sellensr/Vent/Vent_5/sensorPQ.ino

/**************************************************************************/
/*!
  @file sensorPQ.ino

  @section intro Introduction

  An Arduino sketch for running tests on an HMRC DIY ventilator. sensorPQ tab.
  Provides functions to measure patient pressure and flow rate.

  @section author Author

  Written by

  @section license License

  CCBY license

  Code provided only for example purposes. Must not be used for any purpose 
  critical to life or health, or protection of property.
*/
/**************************************************************************/
#ifdef P_BME280
#include <Adafruit_Sensor.h>
#include <Adafruit_BME280.h>
Adafruit_BME280 bmeA, bmeV; // I2C

/**************************************************************************/
/*!
    @brief Do any setup required for patient pressure measurement
    @param none
    @return none
*/
/**************************************************************************/
void setupP(){  // do any setup required for pressure measurement
  unsigned status = bmeA.begin(0x77);  
  PR("bmeA started\n");
  if (!status) {
      Serial.println("Could not find a valid BME280 sensor, check wiring, address, sensor ID!");
      Serial.print("SensorID was: 0x"); Serial.println(bmeA.sensorID(),16);
      Serial.print("        ID of 0xFF probably means a bad address, a BMP 180 or BMP 085\n");
      Serial.print("   ID of 0x56-0x58 represents a BMP 280,\n");
      Serial.print("        ID of 0x60 represents a BME 280.\n");
      Serial.print("        ID of 0x61 represents a BME 680.\n");
  }
  status = bmeV.begin(0x76);  
  if (!status) {
      Serial.println("Could not find a valid BME280 sensor, check wiring, address, sensor ID!");
      Serial.print("SensorID was: 0x"); Serial.println(bmeV.sensorID(),16);
      Serial.print("        ID of 0xFF probably means a bad address, a BMP 180 or BMP 085\n");
      Serial.print("   ID of 0x56-0x58 represents a BMP 280,\n");
      Serial.print("        ID of 0x60 represents a BME 280.\n");
      Serial.print("        ID of 0x61 represents a BME 680.\n");
  }
}
 
/**************************************************************************/
/*!
    @brief Get a new value for patient pressure. Be sure to use pull up
    resistors of about 10K on both SDA and SCL, especially if lines get
    longer or stray close to things like servo motors!
    @param none
    @return the current value for patient pressure in cm H20
*/
/**************************************************************************/
double getP(){  // return the current value for patient pressure in cm H20
  static double dP = 0.0;
  double TA = 0, PA = 0, TV = 0, PV = 0;
  // Measure current state
  TA = bmeA.readTemperature();
  PA = bmeA.readPressure(); // Pa
  TV = bmeV.readTemperature();
  PV = bmeV.readPressure(); // Pa
  //P(PA);PCSL(PV);
  dP = dP * 0.9 + (PV - PA - 0.0) * 0.1; 
  return dP * 100 / 998 / 9.81;    // cm H2O   
}
#endif

#ifdef P_PX137
void setupP(){  // do any setup required for pressure measurement
  
}
 
double getP(){  // return the current value for patient pressure in cm H20
  double v = uno.getV(A_PX137); // instantaneous voltage
  double w = v_tauW; // weighting factor for exponential smoothing
  v_px137v = v_px137v * (1-w) + v * w; // smoothed voltage
  double p = (v_px137v - p_pOffset) * p_pScale;
  return p;   
}
#endif

#ifdef P_NONE
void setupP(){  // do any setup required for pressure measurement
  
}
 
double getP(){  // return the current value for patient pressure in cm H20
  return 0.42;   
}
#endif

#ifdef Q_NONE
/**************************************************************************/
/*!
    @brief Do any setup required for patient flow measurement
    @param none
    @return none
*/
/**************************************************************************/
void setupQ(){  // do any setup required for flow measurement
  
}

/**************************************************************************/
/*!
    @brief Get a new value for patient flow
    @param none
    @return the current value for patient flow in litres / minute
*/
/**************************************************************************/
double getQ(){  // return the current value for patient flow in litres / minute
  return 0.42;
}
#endif

#ifdef Q_PX137
void setupQ(){  // do any setup required for flow measurement
  
}

double getQ(){  // return the current value for patient flow in litres / minute
  double v = uno.getV(A_VENTURI); // instantaneous voltage
  double w = v_tauW; // weighting factor for exponential smoothing
  v_venturiv = v_venturiv * (1-w) + v * w; // smoothed voltage
  double p = (v_venturiv - OFFSET_VENTURI) * PSCALE_VENTURI;
  double q = pow(abs(p),0.5) * QSCALE_VENTURI; 
  // do this supression somewhere else like at the display
  // if(q < MINQ_VENTURI) q = 0; // supress small noisy values for optics!
  return q;
}
#endif

#ifdef Q_CAP2
void setupQ(){  // do any setup required for flow measurement
  for(int i = 0; i < 100; i++){
    v_CPAPv = uno.getV(A_CAP_CPAP);  
    v_PEEPv = uno.getV(A_CAP_PEEP);  
  }
}

double getQ(){  // return the current value for patient flow in litres / minute
  double w = v_tauW; // weighting factor for exponential smoothing
  double v = uno.getV(A_CAP_CPAP); // instantaneous voltage
  v_CPAPv = v_CPAPv * (1-w) + v * w; // smoothed voltage
  v = uno.getV(A_CAP_PEEP); // instantaneous voltage
  v_PEEPv = v_PEEPv * (1-w) + v * w; // smoothed voltage
  v_qCPAP = (v_CPAPv - p_qOffsetCPAP) * p_qScaleCPAP;  // flow on the CPAP side
  v_qPEEP = (v_PEEPv - p_qOffsetPEEP) * p_qScalePEEP;  // minus return flow on the PEEP side
  return v_qCPAP - v_qPEEP;
}
double getQCPAP(){  // return the instantaneous value for CPAP side flow in litres / minute
  return (uno.getV(A_CAP_CPAP) - p_qOffsetCPAP) * p_qScaleCPAP;  // flow on the CPAP side
}
double getQPEEP(){  // return the instantaneous value for PEEP side flow in litres / minute
  return (uno.getV(A_CAP_PEEP) - p_qOffsetPEEP) * p_qScalePEEP;  // flow on the PEEP side
}
#endif
