sellensr/Vent/(commit log)

2020-03-28 lots of stuff
    split into three separate tabs to kep track
    added triggering based on pressure events
    multiple parameters that can be sent from display unit
    multiple outputs that can be used with Arduino serial plotter feature
2020-03-30 CalVoltages to do calibration, P & Q constants from Reza
2020-03-30 p_plotterMode, with menu item to change parameter
    changing servo angles to match new configuration
2020-03-31 Command changes after talking to Display Team
    All commands return a line starting with ACK or NOACK.
    Modified servo settings to reflect new geometry of Rick's Hardware.
    Set IPMAX to 45 and EPMAX to 40.
    Added open all command to make it easier to set up hardware.
    Added Printer Mode command to change what goes to the console.
    Made the alarm buzzer length realy short to avoid annoyance.
    [loop.ino, misc.ino, sensorPQ.ino]
2020-03-31 Added v_pp, v_pl for pressures over entire breath, printed at end of serial line
    Froze the control logic last night. Froze the output today. Vent_2 will remain unchanged and any further development will happen in Vent_3
2020-03-31 Forces v_epl = v_pl, v_ipp = v_pp
    Temporary fix for display team. Extra pressures remain at end of line.
    [loop.ino]
2020-04-03 restore correct v_epl, v_ipp, writing v_pp and v_pl for full breath
    This will need some catchup in the UI code!
    [loop.ino]
2020-04-03 Improve timing
    Add many comments.
    Track current breath states with added start / end variables, and reset them each breath.
    [loop.ino]
2020-04-08 Add two line capillary sensor option
    make sure startInspiration set properly.
    Count all flow for the whole breath, but only when positive into the patient.
    New Q_CAP2 option for flow measurements in both CPAP and PEEP lines.
    Net flow into the patient is CPAP side flow minus PEEP side flow returning.
    Add two more buttons for direct control.
2020-04-08 io changes
    Battery voltage added to output line.
    Calibration coefficients made variables and settable from console command line. Still uses the old defines to set initial values.
2020-04-08 make servo angles settable from console
2020-04-09 Flash save for calibration coefficients
    added p_useSerial1 to avoid trying to interpret noise when Serial 1 is not connected.
    Menu commands for reading, writing, wiping calibration data.
    Menu command for displaying analog voltages to aid in calibration.
    Reduced plotted variables to simplify display on Serial Plotter.
    Changed calibration coefficients to match new RWS rig on Bay Street.
    [Vent_4.ino, flash.ino, misc.ino, out.ino]
2020-04-09 Moving to supported configuration and calibration
    detect a stopped state and block many menu items except when stopped.
    s option to interactively set servo limit positions.
    a option now sets offsets automatically if given a negative argument.
    added separate tracking of flow on CPAP and PEEP sides.
    added v_tauW as the weighting factor for smoothing, but still doesn't respond to the time constant setting in p_tau.
    YGK_GENERIC version now starts with servos at 90, offsets 0, and scale factors 1, so you need to go through a configuration process.
    [Vent_4.ino, flash.ino, loop.ino, misc.ino, out.ino, sensorPQ.ino]
2020-04-09 Added flow calibration and PDF instructions
    It should now be possible to set and save the servo geometry and calibration factors from the Serial Monitor of the Arduino IDE. The instructions worked when I followed them. Please let me know what I have left out!
2020-04-09 Damping time constant
    Added user settable damping time constant for flow measurements. Exponential smoothing gives a first order response and 0.1 seconds seems fast enough to capture what we are looking for while supressing the worst of the noise.
    [Vent_4.ino, loop.ino, misc.ino]
2020-04-10 Display missing Error. Slow loop() Error
    Monitor last time a console command was received and throw an error if it has been too long.
    Monitor how quickly the control loop runs and throw an error if it has been running too slowly.
    [Vent_4.ino, loop.ino, misc.ino]
2020-04-11 Added MAX_COMMAND_LENGTH
    Recover gracefully if a command string gets too long by throwing the content away and converting the rest to a Z command. The hazard is that a bad command will get an ACK message saying it did nothing.
    [Vent_4.ino, flash.ino, misc.ino, out.ino]
2020-04-11 Model, Firmware and Serial Numbers, More Safety
    Added firmware version number 0.4.5 means pre release, Vent_4, about 5 iterations since Vent_3.
    Current Hardware model is 3, with flow elements in both directions.
    Hardware model and serial number can be set or checked with M, and are saved with calibration and configuration data.
    Stop mode (x, or X) will go back to run mode (R) automatically after 30 seconds to meet requirements in the standard. There will be an error thrown just before it goes back to run mode as a warning. You can extend the stop time by sending another stop command before it goes to run.
    [Vent_4.ino, flash.ino, loop.ino, misc.ino]
2020-04-13 changed analog input pins to match hard wired links on McLaughlin Board
    Moved jumpers to match on RWS prototype. Glad I kept flexible connections on this one! All worked well after recalibrating offsets to put 0 flow in the right place.
2020-04-13 More documentation and reset default values
    That should make it clearer that the place to set the calibration coefficients now is in the config process and store in the config file, rather than change in source code te way we started out.
    [Vent_4.ino]
2020-04-13 Add VENT_BUZ_ERROR to specify which errors make noise
    Local sound alarms now restricted to External Error, Display not there, loop running too slow, or returning to run mode warning.
    [Vent_4.ino, loop.ino]
2020-04-13 Alarm and ACK issues
    R command will now return ACK every time. loop() no longer uses it as shorthand.
    Alarm buzzer will be turned off when millis() < 40000 giving display time to wake up.
    If no clear alarm is received, buzzer will sound again after about 30 seconds.
    [Vent_4.ino, loop.ino, misc.ino]
2020-04-14 Ship Vent_4 (I hope)
    Added some documentation.
    Made STOP_MAX large to prevent auto restarts in less than a week.
    Added ALARM_STOP to sound the buzzer if the unit has been in stop mode too long.
    Set variables to wake up in stop mode.
    Created setRun() to move all appropriate values to run mode in a single location.
    Go to run mode with button push (no buttons on production hardware.)
    Verified and/or corrected to be sure all console commands result in at least one line starting with either ACK or NOACK. ACK means recognized first letter in received command line, but not necessarily validated or action taken.
    [Vent_4.ino, buttons.ino, loop.ino, misc.ino]
2020-04-15 Added current version copies of lbraries to repository
    These need to be in the Arduino libraries folder in order to compile
2020-04-17 flashy stuff
    make setupFlash provide a return, check patient file.
    read and write patient file to flash and update v_patientSet.
    go to run mode if patient set and have waited long enough to hear from display.
2020-04-17 write patient flash when appropriate
    still needs code for menu and auto save after display done with setup.
2020-04-17 track state and update patient file
    track the time of the first setRun().
    track if a cal file is found.
    track if we started recently.
    track the last patient info change.
    don't automatically create a calibration file.
    write patient file when needed, but not too often to save the flash.
2020-04-17 don't rewrite patient data just read from flash.
2020-04-17 wipePatFlash restores patient defaults
2020-04-27 Move towards blower control with pSet
    Add set point variables for target pressure and high flow limit.
    Add v_ieEntered to change phase immediately with no transition.
2020-04-27 Sign error on inspiration trigger tolerance in Vent_5
    Fixed sign in Vent_5 and YGKMV.
    Added integral control for blower, restarting integration for each breath phase.
    Moved blower speed init up so it happens immediately.
    [YGKMV.cpp, YGKMV.h, YGKMVflash.cpp, YGKMVrun.cpp, loop.ino]
